ostojaatanasijevic/DS100M08V/documentation/figs/3d_view_top.png

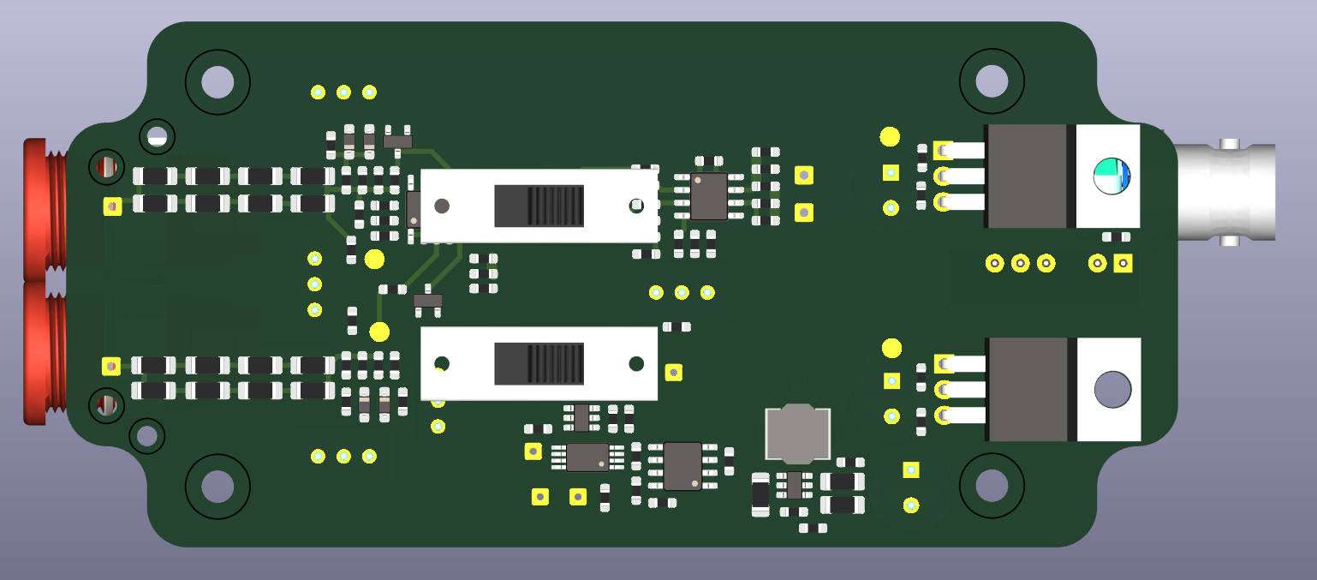
documentation/figs/3d_view_top.png
