ostojaatanasijevic/DS100M08V/documentation/figs/case.png

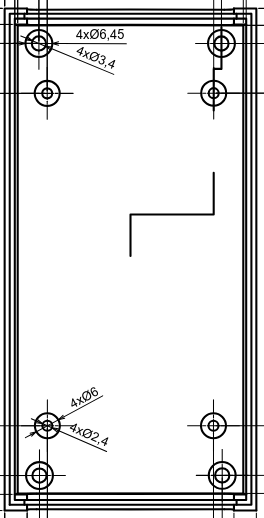
documentation/figs/case.png
