ostojaatanasijevic/DS100M08V/documentation/figs/pomona.webp

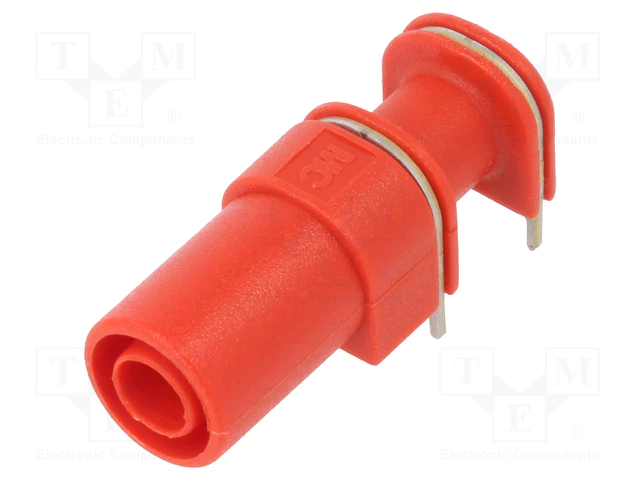
documentation/figs/pomona.webp
