ostojaatanasijevic/DS100M08V/BOM.xls

 |  | Order Qty. | Price (EUR) | Ext.: (EUR)
667-ERJ-PA3J101V | Thick Film Resistors - SMD 0603 100ohm 5% Anti-Surge AEC-Q200 | 2 | 0.035 | 0.07 | 0.7
667-ERA-3AEB103V | Thin Film Resistors - SMD 0603 1/10W 10Kohms 0.1% 25ppm | 10 | 0.087 | 0.87 | 1.74
791-0805N100J501CT | Multilayer Ceramic Capacitors MLCC - SMD/SMT 10pF, +-5%, 500V | 8 | 0.053 | 0.424 | 1.06
768-JR500HV | Trimmer/Variable Capacitors 8.0 - 50PF 350V | 2 | 3.95 | 7.9 | 19.75
80-C0603C105K4PAC | Multilayer Ceramic Capacitors MLCC - SMD/SMT 16V 1uF X5R 0603 10% | 5 | 0.03 | 0.15 | 3
621-BAT54S-F | Schottky Diodes & Rectifiers 30V 350mW | 10 | 0.089 | 0.89 | 0.89
652-CR0603FX-1000ELF | Thick Film Resistors - SMD 100ohm 1% 1/10W | 2 | 0.005 | 0.01 | 0.5
603-RT0603BRD101KL | Thin Film Resistors - SMD 1K ohm 0.1% 25 ppm Thin Film | 10 | 0.069 | 0.69 | 6.9
603-CC603JRNPO8BN471 | Multilayer Ceramic Capacitors MLCC - SMD/SMT 25 V 470pF C0G 0603 5% | 6 | 0.039 | 0.234 | 1.56
https://www.tme.eu/rs/en/details/ad8039arz/smd-operational-amplifiers/analog-devices/ |  | 1 | 3 | 3
https://www.tme.eu/rs/en/details/ad8009arz/smd-operational-amplifiers/analog-devices/ |  | 1 | 2.65 | 2.65
https://www.tme.eu/rs/en/details/am1ds-0509djz/dc-dc-converters/aimtec/ |  | 1 | 2.7 | 2.7
7805 |  | 1 | 0.3 | 0.3
7905 |  | 1 | 0.3 | 0.3
BNC connector |  | 1 | 1.4 | 1.4
4 mm | https://www.aliexpress.com/item/1005005352800055.html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 | 2 | 1.26 | 2.52
kutija | https://www.mgelectronic.rs/kupl-z98 | 1 | 2.5 | 2.5
USB B | https://www.mgelectronic.rs/mini-usb-b-uti%C4%8Dnica-smd-4-pina | 1 | 0.8 | 0.8
USB C | https://eu.mouser.com/ProductDetail/TE-Connectivity/2480843-1?qs=dbcCsuKDzFVHhjcKyfNgvQ%3D%3D | 1 | 1.47 | 1.47
PCB |  | 1 | 1 | 1
4 mm kabl | za sodnu | 2 | 1 | 2
krokodilke |  | 2 | 1.7 | 3.4
603-RT0603BRD0710KL | Thin Film Resistors - SMD 10K ohm 0.1% 1/10W | 2 | 0.063 | 0.126
 |  |  |  | 0
 |  |  |  | 0
 |  |  |  | 35.404
