ostojaatanasijevic/DS100M08V/simulacije/910_offset_calibration.asc

C1: cap; 10p
C2: cap; 10p
C3: cap; 10p
C4: cap; 10p
C9: cap; 120p
C11: cap; 47p
C13: cap; 470p
C16: cap; 360p
C21: cap; {par_cap}
R1: res; {1Meg * (100 +res_tol)/100}
R2: res; 10Meg
R3: res; 10k
R4: res; {100k * x}
R5: res; {100k - x*100k}
R7: res; 25
R11: res; {1Meg * (100 +res_tol)/100}
R12: res; {1Meg * (100 +res_tol)/100}
R13: res; {1Meg * (100 +res_tol)/100}
U2: AD8038
V1: voltage; 2.75
V2: voltage; -2.75
V3: voltage; -3m
V4: voltage; SINE(0 0 10Meg)
V5: voltage; 9
V6: voltage; -9
V7: voltage; {five}
V8: voltage; {five}
Named nets: 0, 2.5V, -2.5V, 5V, -5V, 9V, -9V
.tran 0 1u 0 1n
1 / 400
.param five=5
82.5 dB CMRR at 100 kHz
.param tolerance=-1
.param par_cap=10p
.param res_tol=-0.1
.param gain=100
.step param x 0.1 0.9 0.1
