ostojaatanasijevic/DS100M08V/simulacije/ac_analysis.asc

B1: bv; V=20*(V(diff+) - V(diff-))
C1: cap; {par_cap}
C2: cap; 470p
C3: cap; 10p
C4: cap; 10p
C5: cap; 10p
C6: cap; 10p
C7: cap; 470p
C8: cap; 470p
C9: cap; 10p
C10: cap; 10p
C11: cap; 10p
C12: cap; 10p
C15: cap; 55.5p
C16: cap; 55.5p
C17: cap; {par_cap}
C18: cap; {par_cap}
C19: cap; {par_cap}
C20: cap; {par_cap}
C21: cap; 470p
R1: res; {1Meg * (100 +res_tol)/100}
R2: res; {1Meg * (100 +res_tol)/100}
R3: res; {1Meg * (100 +res_tol)/100}
R4: res; {1Meg * (100 +res_tol)/100}
R5: res; 10k
R10: res; 10k
R11: res; 25
R12: res; 25
R13: res; {Rf / 200 * gain * (100 + tolerance) / 100}
R14: res; {1Meg * (100 +res_tol)/100}
R15: res; {Rf * (100 - tolerance)/100}
R16: res; {Rf * (100 - tolerance)/100}
R17: res; 100k
R18: res; {Rf / 200 * gain * (100 + tolerance) / 100}
R19: res; {1Meg * (100 +res_tol)/100}
R20: res; {1Meg * (100 +res_tol)/100}
R21: res; {1Meg * (100 +res_tol)/100}
U2: AD8039
U3: AD8039
U4: AD8009an
V1: voltage; 2.75
V2: voltage; -2.75
V3: voltage; ""; AC 100
V4: voltage; 9
V5: voltage; 10
V6: voltage; -9
V7: voltage; {five}
V8: voltage; {five}
V9: voltage; ""; AC 100
Named nets: 0, 2.5V, -2.5V, 5V, -5V, 9V, -9V, diff+, diff-
;tran 0 10m 0 1n
1 / 400
.param five=5
82.5 dB CMRR at 100 kHz
.param tolerance=-1
.param par_cap=10p
.param res_tol=-0.1
.param gain=100
.ac dec 100 100 150Meg
.param Rf = 1000
