ostojaatanasijevic/DS100M08V/simulacije/ac_analysis_wider_output.asc

B1: bv; V=20*(V(diff+) - V(diff-))
C1: cap; {par_cap}
C2: cap; 470p
C3: cap; 10p
C4: cap; 10p
C5: cap; 10p
C6: cap; 10p
C7: cap; 470p
C8: cap; 470p
C9: cap; 10p
C10: cap; 10p
C11: cap; 10p
C12: cap; 10p
C13: cap; 100n
C15: cap; 55.5p
C16: cap; 55.5p
C17: cap; {par_cap}
C18: cap; {par_cap}
C19: cap; {par_cap}
C20: cap; {par_cap}
C21: cap; 470p
D1: diode; 1N4148
D2: diode; 1N4148
Q1: npn; 2N3904
Q2: pnp; 2N3906
Q3: npn; 2N3904
R1: res; {1Meg * (100 +res_tol)/100}
R2: res; {1Meg * (100 +res_tol)/100}
R3: res; {1Meg * (100 +res_tol)/100}
R4: res; {1Meg * (100 +res_tol)/100}
R5: res; 10k
R6: res; 50k
R7: res; {100k * (1 - rot)}
R8: res; {100k * (rot)}
R9: res; 2k
R10: res; 10k
R11: res; 25
R12: res; 25
R13: res; {Rf / 200 * gain * (100 + tolerance) / 100}
R14: res; {1Meg * (100 +res_tol)/100}
R15: res; {Rf * (100 - tolerance)/100}
R16: res; {Rf * (100 - tolerance)/100}
R17: res; 100k
R18: res; {Rf / 200 * gain * (100 + tolerance) / 100}
R19: res; {1Meg * (100 +res_tol)/100}
R20: res; {1Meg * (100 +res_tol)/100}
R21: res; {1Meg * (100 +res_tol)/100}
R22: res; 2k
R23: res; 3
R24: res; 3
R25: res; 200
R26: res; 50
R27: res; 2k
U1: AD8009an
U2: AD8039
U3: AD8039
U4: AD8009an
V1: voltage; 2.75
V2: voltage; -2.75
V3: voltage; ""; AC 100
V4: voltage; 9
V5: voltage; 10
V6: voltage; -9
V7: voltage; {five}
V8: voltage; {five}
V9: voltage; ""; AC 100
V10: voltage; 15
V11: voltage; -15
Named nets: 0, 2.5V, -2.5V, 5V, -5V, 9V, -9V, diff+, diff-, 15V, -15V
;tran 0 10m 0 1n
1 / 400
.param five=5
82.5 dB CMRR at 100 kHz
.param tolerance=-1
.param par_cap=10p
.param res_tol=-0.1
.param gain=100
.ac dec 100 0.1 150Meg
.param Rf = 1000
.param rot = 0.6
