ostojaatanasijevic/DS100M08V/simulacije/701_capacitance_multiplier.asc

B1: bv; V=-V(vcc_in)
C1: cap; 47µ
C2: cap; 47µ
C3: cap; 47µ
I1: current; 30m
I2: current; 30m
I3: current; -30m
Q1: npn; 2N3904
Q2: pnp; 2N2905
R1: res; 1k
R2: res; 3.3k
R3: res; 1k
R4: res; 1k
R5: res; 2.2k
R6: res; 1k
R7: res; 2.2k
R322: res; 3.3k
U2: bd679
V1: voltage; PULSE(-1 1 0 10u 10u 1n 20u)
V2: voltage; 9
V3: voltage; PULSE(-1 1 0 {t2} {t2} 1n {2*t2})
V4: voltage; 9
Named nets: 0, vee_in, vcc_in
.tran 1000m
.param t2 = 0.5u
.lib BD679.SP3
