ostojaatanasijevic/DS100M08V/simulacije/000_init.asc

B1: bv; V=20*(V(diff+) - V(diff-))
C1: cap; 5p
C2: cap; 360p
C3: cap; 10p
C4: cap; 10p
C5: cap; 10p
C6: cap; 10p
C7: cap; 470p
C8: cap; 470p
C9: cap; 10p
C10: cap; 10p
C11: cap; 10p
C12: cap; 10p
C13: cap; 120p
C14: cap; 120p
C15: cap; 47p
C16: cap; 47p
C17: cap; 20p
C18: cap; 0.5p
C19: cap; 0.5p
C20: cap; 0.5p
C21: cap; 360p
C22: cap; 20p
R1: res; 1Meg
R2: res; 1Meg
R3: res; 1Meg
R4: res; 1Meg
R5: res; 10k
R6: res; 1Meg
R7: res; 1Meg
R8: res; 1Meg
R9: res; 1Meg
R10: res; 10k
R11: res; 25
R12: res; 25
R13: res; 100
R14: res; 100
R15: res; 2000
R16: res; 2000
R17: res; 100k
U2: AD8038
U3: AD8038
U4: AD8009an
V1: voltage; 2.75
V2: voltage; -2.75
V3: voltage; SINE(0 20 50Meg)
V4: voltage; 9
V5: voltage; SINE(400 100 100k)
V6: voltage; -9
V7: voltage; {five}
V8: voltage; {five}
Named nets: 0, 2.5V, -2.5V, 5V, -5V, 9V, -9V, diff+, diff-
.tran 0 10m
.lib TLV354.LIB
.lib lm7171.lib
1 / 400
at +2.75V, max output is 2.5V, meaning peak input is 1kV.
.param five=5
82.5 dB CMRR at 100 kHz
