ostojaatanasijevic/DS100M08V/simulacije/101_varicap.asc

B1: bv; V=20*(V(diff+) - V(diff-))
C1: cap; {par_cap}
C2: cap; 360p
C3: cap; 10p
C4: cap; 10p
C5: cap; 10p
C6: cap; 10p
C7: cap; 470p
C8: cap; 470p
C9: cap; 10p
C10: cap; 10p
C11: cap; 10p
C12: cap; 10p
C13: cap; 120p
C14: cap; 120p
C15: cap; 47p
C16: cap; 47p
C17: cap; {par_cap}
C18: cap; {par_cap}
C19: cap; {par_cap}
C20: cap; {par_cap}
C21: cap; 360p
R1: res; 1Meg
R2: res; 1Meg
R3: res; 1Meg
R4: res; 1Meg
R5: res; 10k
R6: res; 1Meg
R7: res; 1Meg
R8: res; 1Meg
R9: res; 1k
R10: res; 10k
R11: res; 25
R12: res; 25
R13: res; {10 * gain * (100 + tolerance) / 100}
R14: res; 1Meg
R15: res; {2000 * (100 - tolerance)/100}
R16: res; {2000 * (100 - tolerance)/100}
R17: res; 100k
R18: res; {10 * gain * (100 + tolerance) / 100}
U1: SMV1255
U2: AD8038
U3: AD8038
U4: AD8009an
V1: voltage; 2.75
V2: voltage; -2.75
V3: voltage; SINE(0 200 50Meg)
V4: voltage; 9
V5: voltage; SINE(400 100 10Meg)
V6: voltage; -9
V7: voltage; {five}
V8: voltage; {five}
V9: voltage; 4
Named nets: 0, 2.5V, -2.5V, 5V, -5V, 9V, -9V, diff+, diff-
.tran 0 10m 0 1n
1 / 400
.param five=5
82.5 dB CMRR at 100 kHz
.param tolerance=-1
.param par_cap=10p
.param res_tol=-0.1
.param gain=100
.lib SMV1255-079LF.lib
