ostojaatanasijevic/DS100M08V/simulacije/102_varicap_only.asc

C1: cap; 100n
C2: cap; 100p
R9: res; 100k
U1: SMV1255
V1: voltage; 2.75
V2: voltage; -2.75
V4: voltage; 9
V6: voltage; -9
V7: voltage; {five}
V8: voltage; {five}
V9: voltage; {bias}
V10: voltage; SINE(0 1 1Meg)
Named nets: 0, 2.5V, -2.5V, 9V, -9V, 5V, -5V, mid, input
.tran 0 100.26u 100.24u
.param five=5
.lib SMV1255-079LF.lib
.step param bias list 0 1 2 3 4 5
