ostojaatanasijevic/DS100M08V/simulacije/201_pwm_buffer.asc

C1: cap; 1µ
C3: cap; 1µ
R1: res; 100k
U1: opamp2; TLV9062
U2: opamp2; TLV9062
V1: voltage; 2.75
V2: voltage; -2.75
V3: voltage; PULSE(0 5 0 0 0 {d * 10u} 10u)
V4: voltage; 9
V6: voltage; -9
V7: voltage; {five}
V8: voltage; {five}
Named nets: 0, 2.5V, -2.5V, 9V, -9V, 5V, -5V, leak
.tran 0 100m 0 uic
.param five=5
.step param d list 0.1 0.2 0.3 0.4
.lib tlv9062.lib
.ic V(leak) = 1
