ostojaatanasijevic/DS100M08V/simulacije/400_output_offset.asc

B1: bv; V=20*(V(diff+) - V(diff-))
C1: cap; {par_cap}
C17: cap; {par_cap}
R1: res; {Rf*100}
R2: res; {(1- ratio) * 100k}
R3: res; {(ratio) * 100k}
R4: res; {Rf/20}
R5: res; {Rf}
R6: res; {Rf}
R7: res; {Rf/20}
R9: res; {(1- ratio) * 100k}
R10: res; {(ratio) * 100k}
R11: res; {Rf*50}
R13: res; {Rf/2}
R15: res; {Rf}
R16: res; {Rf}
R17: res; 100k
R18: res; {Rf/2}
U1: AD8009an
U4: AD8009an
V1: voltage; 2.75
V2: voltage; -2.75
V3: voltage; PULSE(0.2 -0.2 0 500p 500p 10n 20n)
V4: voltage; 9
V5: voltage; PULSE(-0.2 0.2 0 500p 500p 10n 20n)
V6: voltage; -9
V7: voltage; {five}
V8: voltage; {five}
Named nets: 0, 2.5V, -2.5V, 9V, -9V, 5V, -5V, diff+, diff-, output_2, output
.tran 0 100n 0 1n
.param five=5
82.5 dB CMRR at 100 kHz
.step param Rf list 200 1k 2k
.param tolerance=-1
.param par_cap=10p
.param res_tol=-0.1
.param gain=100
.param ratio = 0.01
