ostojaatanasijevic/DS100M08V/simulacije/700_psu.asc

C1: cap; 10µ
C2: cap; 10µ
C3: cap; 3.43p
C4: cap; 3.43p
D1: diode; 1N4148
L1: ind; 4.7µ
L2: ind; 4.7µ
M1: nmos; BSC060N10NS3
R1: res; 50
R2: res; 8570
R3: res; 35m
R4: res; 8570
R5: res; 35m
V1: voltage; PULSE(0 10 0 0 0 {d / f} {1/f})
V2: voltage; 3.6V
Named nets: 0
.param f = 1Meg
.param d = 0.32
.tran 1000m
