ostojaatanasijevic/DS100M08V/simulacije/Draft1.asc

L1: ind; 61.4µ
R1: res; 149.6
V1: voltage; SINE(0 0.456 100k)
Named nets: 0
.tran 1m
