ostojaatanasijevic/DS100M08V/DS100M08KV.kicad_pcb

## KiCad design DS100M08KV.kicad_pcb (2025-10-20)

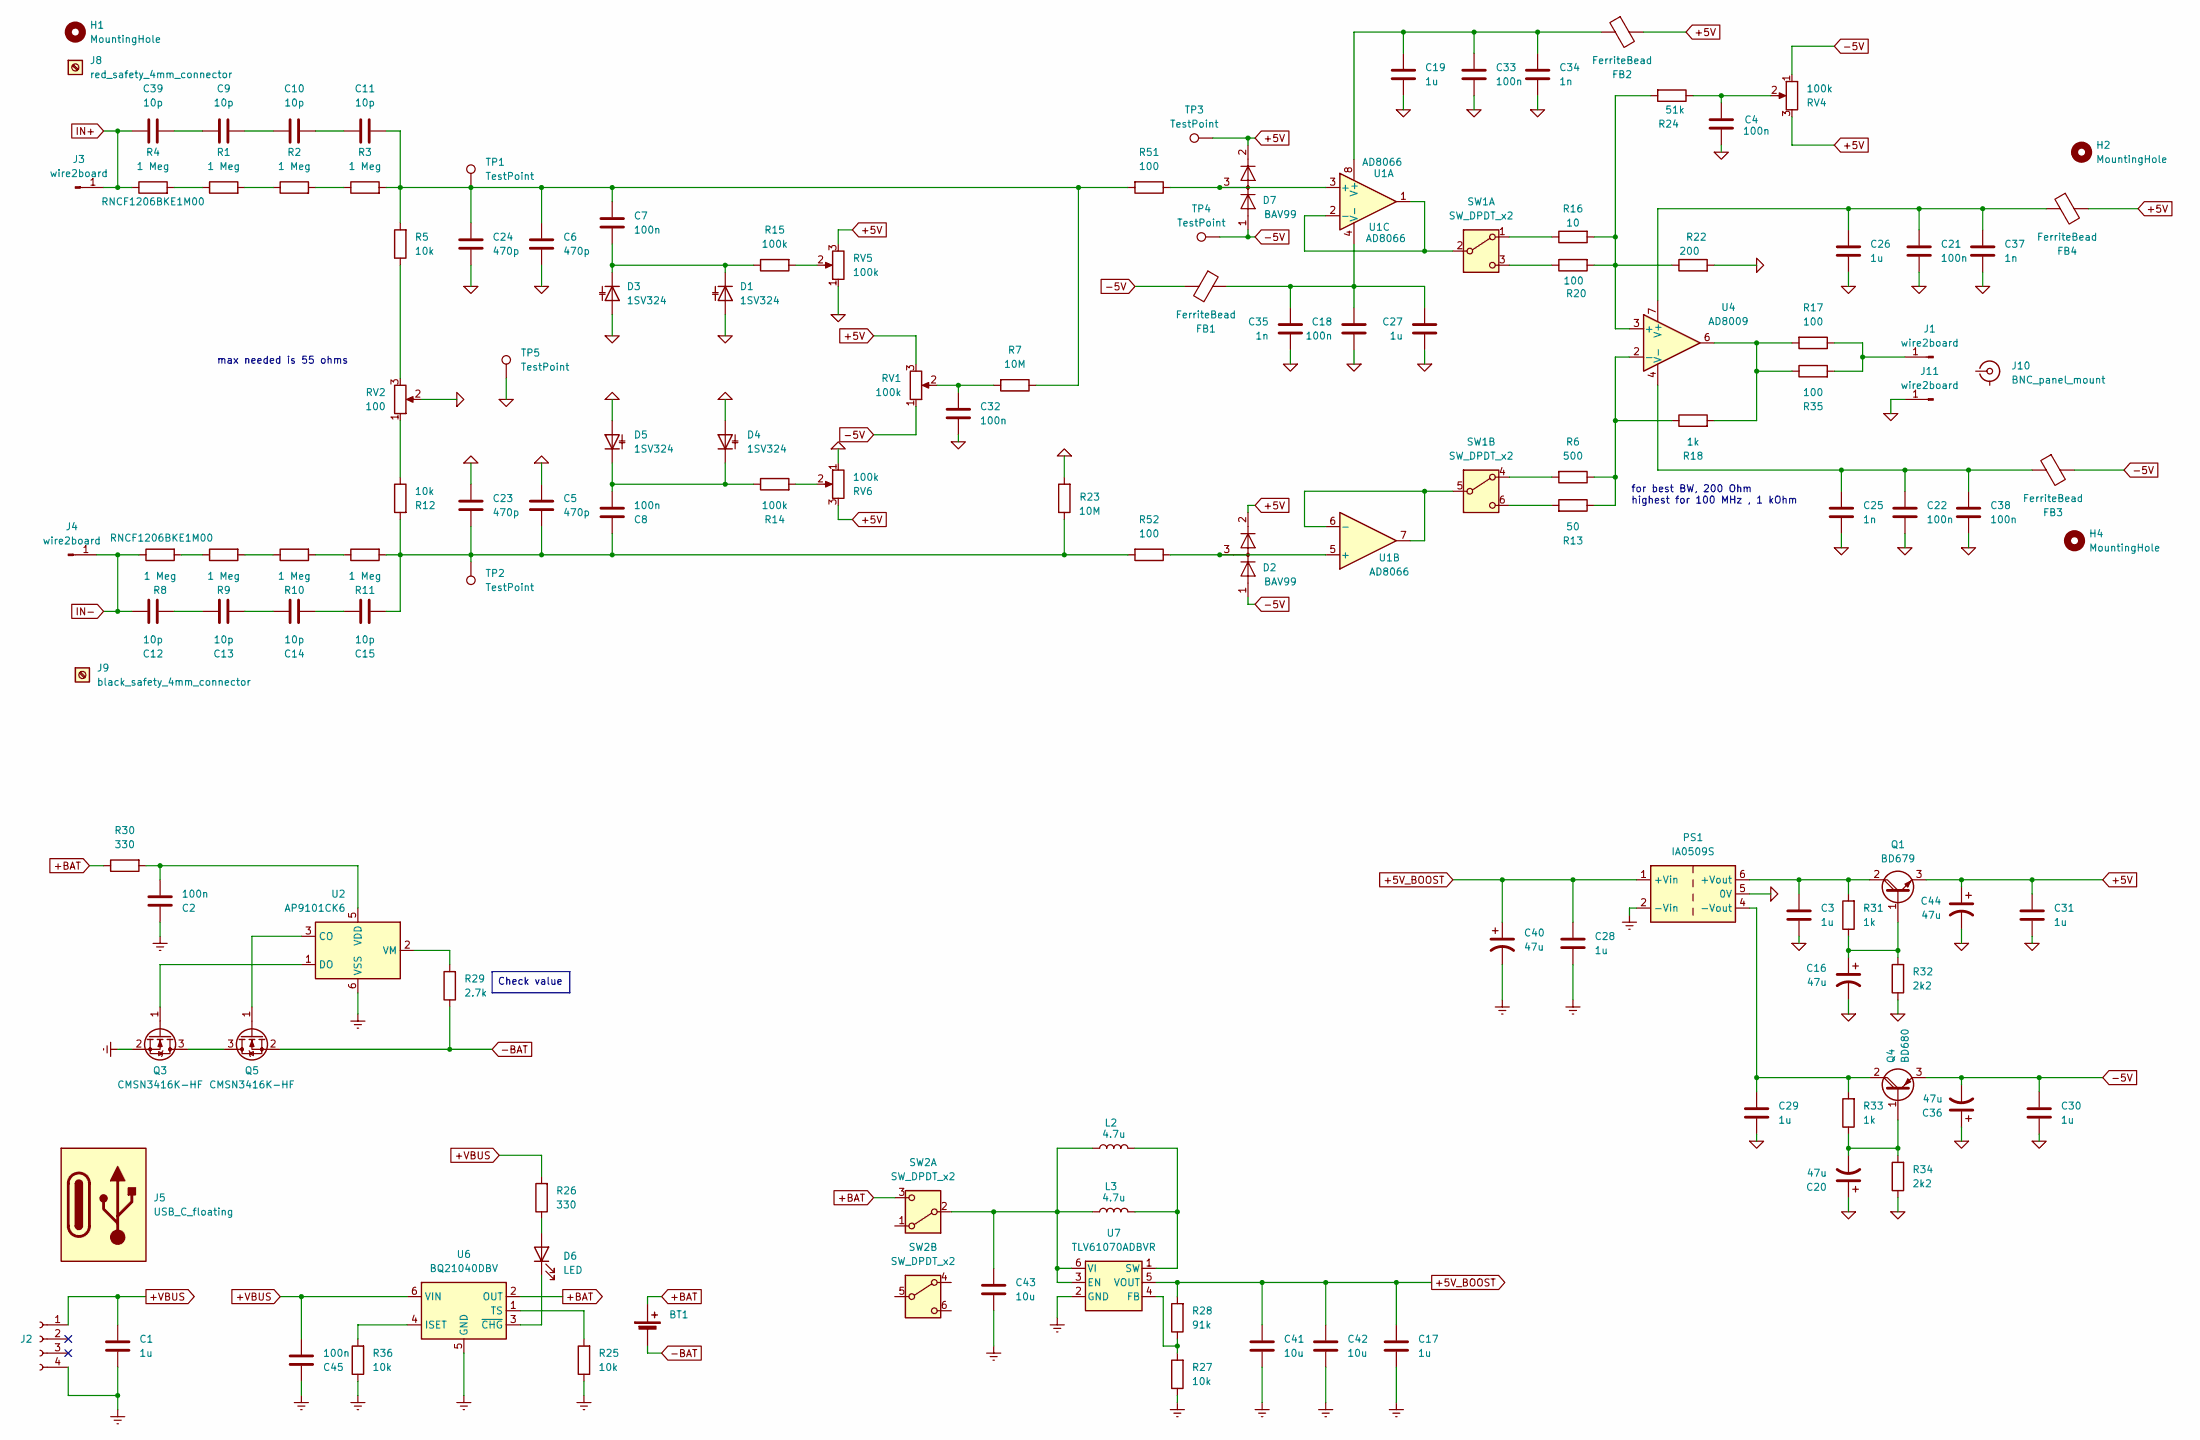
[picture p8: schematic DS100M08KV.kicad_sch, 1:200 800V 100 MHz differential probe]

Parts:
BT1: Battery_Cell; battery_holder
C1, C3, C17, C19, C26, C27, C28, C29, C30, C31: 1u; R_0603_1608Metric_Pad0.98x0.95mm_HandSolder
C2, C4, C7, C8, C18, C21, C22, C32, C33, C38, C45: 100n; R_0603_1608Metric_Pad0.98x0.95mm_HandSolder
C5, C6, C23, C24: 470p; R_0603_1608Metric_Pad0.98x0.95mm_HandSolder
C9, C10, C11, C12, C13, C14, C15, C39: 10p; R_1206_3216Metric_Pad1.30x1.75mm_HandSolder
C16, C20, C36, C40, C44: 47u; CP_Radial_D5.0mm_P2.00mm
C25, C34, C35, C37: 1n; R_0603_1608Metric_Pad0.98x0.95mm_HandSolder
C41, C42, C43: 10u; R_1206_3216Metric_Pad1.30x1.75mm_HandSolder
D1, D3, D4, D5: 1SV324; D_SOD-323_HandSoldering
D2, D7: BAV99; SOT-23
D6: LED; LED_D3.0mm_FlatTop
FB1, FB2, FB3, FB4: FerriteBead; L_0603_1608Metric_Pad1.05x0.95mm_HandSolder
H1, H2, H4: MountingHole; M3_with_screw
J1, J3, J4, J11: wire2board; SolderWire-0.25sqmm_1x01_D0.65mm_OD1.7mm
J2: Conn_01x04_Socket; JST_PH_B4B-PH-K_1x04_P2.00mm_Vertical
J5: USB_C_floating
J8: red_safety_4mm_connector; black_safety_4mm_connector
J9: black_safety_4mm_connector
J10: BNC_panel_mount
L2: 4.7u; L_Radial_D7.5mm_P3.50mm_Fastron_07P
L3: 4.7u; L_Bourns_SRN6045TA
PS1: IA0509S; Converter_DCDC_XP_POWER-IAxxxxS_THT
Q1: BD679; TO-126-3_Vertical
Q3, Q5: CMSN3416K-HF; SOT-23
Q4: BD680; TO-126-3_Vertical
R1, R2, R3, R9, R10, R11: 1 Meg; R_1206_3216Metric_Pad1.30x1.75mm_HandSolder
R4, R8: 1 Meg; R_1206_3216Metric_Pad1.30x1.75mm_HandSolder; Partnumber RNCF1206BKE1M00
R5, R12, R25, R27, R36: 10k; R_0603_1608Metric_Pad0.98x0.95mm_HandSolder
R6: 500; R_0603_1608Metric_Pad0.98x0.95mm_HandSolder
R7, R23: 10M; R_0603_1608Metric_Pad0.98x0.95mm_HandSolder
R13: 50; R_0603_1608Metric_Pad0.98x0.95mm_HandSolder
R14, R15: 100k; R_0603_1608Metric_Pad0.98x0.95mm_HandSolder
R16: 10; R_0603_1608Metric_Pad0.98x0.95mm_HandSolder
R17, R20, R35, R51, R52: 100; R_0603_1608Metric_Pad0.98x0.95mm_HandSolder
R18, R31, R33: 1k; R_0603_1608Metric_Pad0.98x0.95mm_HandSolder
R22: 200; R_0603_1608Metric_Pad0.98x0.95mm_HandSolder
R24: 51k; R_0603_1608Metric_Pad0.98x0.95mm_HandSolder
R26, R30: 330; R_0603_1608Metric_Pad0.98x0.95mm_HandSolder
R28: 91k; R_0603_1608Metric_Pad0.98x0.95mm_HandSolder
R29: 2.7k; R_0603_1608Metric_Pad0.98x0.95mm_HandSolder
R32, R34: 2k2; R_0603_1608Metric_Pad0.98x0.95mm_HandSolder
RV1, RV4, RV5, RV6: 100k; Potentiometer_Bourns_3296W_Vertical
RV2: 100; Potentiometer_Bourns_3296W_Vertical
SW1, SW2: SW_DPDT_x2; DPDT_bigger
TP1, TP2, TP3, TP4, TP5: TestPoint; TestPoint_Pad_D2.0mm
U1: AD8066; SOIC-8_3.9x4.9mm_P1.27mm
U2: AP9101CK6; SOT-23-6
U4: AD8009; SOIC-8_3.9x4.9mm_P1.27mm
U6: BQ21040DBV; SOT-23-6
U7: TLV61070ADBVR; SOT-23-6

Connections:
0: C3.2, C4.1, C5.1, C6.1, C16.2, C18.1, C19.1, C20.1, C21.1, C22.1, C23.1, C24.1, C25.1, C26.1, C27.1, C29.2, C30.2, C31.2, C32.1, C33.1, C34.1, C35.1, C36.1, C37.1, C38.1, C44.2, D1.2 (A), D3.2 (A), D4.2 (A), D5.2 (A), J11.1, PS1.5 (0V), R22.2, R23.2, R32.1, R34.1, RV2.2, RV5.1, RV6.1, TP5.1
+5V: C31.1, C44.1, D2.2 (A), D7.2 (A), FB2.2, FB4.2, Q1.3 (E), RV1.3, RV4.3, RV5.3, RV6.3, TP3.1
+5V_BOOST: C17.2, C28.1, C40.1, C41.2, C42.2, PS1.1 (+Vin), R28.2, U7.5 (VOUT)
+BAT: BT1.1 (+), R30.1, SW2.3 (C), U6.2 (OUT)
+VBUS: C1.1, C45.1, J2.1, R26.2, U6.6 (VIN)
-5V: C30.1, C36.2, D2.1 (K), D7.1 (K), FB1.2, FB3.2, Q4.3 (E), RV1.1, RV4.1, TP4.1
-BAT: BT1.2 (-), Q5.2 (S), R29.1
Earth: C1.2, C2.2, C17.1, C28.2, C40.2, C41.1, C42.1, C43.1, C45.2, J2.4, PS1.2 (-Vin), Q3.2 (S), R25.1, R27.1, R36.1, U2.6 (VSS), U6.5 (GND), U7.2 (GND)
IN+: C39.2, J3.1, R4.1
IN-: C12.2, J4.1, R8.1
unnamed: C4.2, R24.1, RV4.2
unnamed: C10.1, C11.2
unnamed: C9.1, C10.2
unnamed: C6.2, C7.2, C11.1, C24.2, R3.2, R5.2, R7.1, R51.2, TP1.1
unnamed: C12.1, C13.2
unnamed: C13.1, C14.2
unnamed: C14.1, C15.2
unnamed: C5.2, C8.2, C15.1, C23.2, R11.2, R12.2, R23.1, R52.2, TP2.1
unnamed: C32.2, R7.2, RV1.2
unnamed: C9.2, C39.1
unnamed: C7.1, D1.1 (K), D3.1 (K), R15.1
unnamed: C8.1, D4.1 (K), D5.1 (K), R14.1
unnamed: D6.2 (A), R26.1
unnamed: D6.1 (K), U6.3 (~CHG)
unnamed: J1.1, R17.1, R35.2
unnamed: C3.1, PS1.6 (+Vout), Q1.2 (C), R31.2
unnamed: C29.1, PS1.4 (-Vout), Q4.2 (C), R33.2
unnamed: C16.1, Q1.1 (B), R31.1, R32.2
unnamed: Q3.3 (D), Q5.3 (D)
unnamed: Q3.1 (G), U2.1 (DO)
unnamed: C20.2, Q4.1 (B), R33.1, R34.2
unnamed: Q5.1 (G), U2.3 (CO)
unnamed: R1.1, R4.2
unnamed: R1.2, R2.1
unnamed: R2.2, R3.1
unnamed: R5.1, RV2.3
unnamed: R8.2, R9.1
unnamed: R9.2, R10.1
unnamed: R10.2, R11.1
unnamed: R12.1, RV2.1
unnamed: R14.2, RV6.2
unnamed: R15.2, RV5.2
unnamed: R17.2, R18.2, R35.1, U4.6
unnamed: R16.1, SW1.1 (A)
unnamed: SW1.2 (B), U1.1, U1.2 (-)
unnamed: R20.1, SW1.3 (C)
unnamed: R6.2, SW1.4 (A)
unnamed: SW1.5 (B), U1.6 (-), U1.7
unnamed: R13.2, SW1.6 (C)
unnamed: C43.2, L2.1, L3.1, SW2.2 (B), U7.3 (EN), U7.6 (VI)
unnamed: D7.3 (K), R51.1, U1.3 (+)
unnamed: D2.3 (K), R52.1, U1.5 (+)
unnamed: C19.2, C33.2, C34.2, FB2.1, U1.8 (V+)
unnamed: C18.2, C27.2, C35.2, FB1.1, U1.4 (V-)
unnamed: C2.1, R30.2, U2.5 (VDD)
unnamed: R29.2, U2.2 (VM)
unnamed: R16.2, R20.2, R22.1, R24.2, U4.3 (+)
unnamed: R6.1, R13.1, R18.1, U4.2 (-)
unnamed: C21.2, C26.2, C37.2, FB4.1, U4.7 (V+)
unnamed: C22.2, C25.2, C38.2, FB3.1, U4.4 (V-)
unnamed: R36.2, U6.4 (ISET)
unnamed: R25.2, U6.1 (TS)
unnamed: R27.2, R28.1, U7.4 (FB)
unnamed: L2.2, L3.2, U7.1 (SW)

Notes on the sheet:
for best BW, 200 Ohm highest for 100 MHz , 1 kOhm
max needed is 55 ohms
Check value

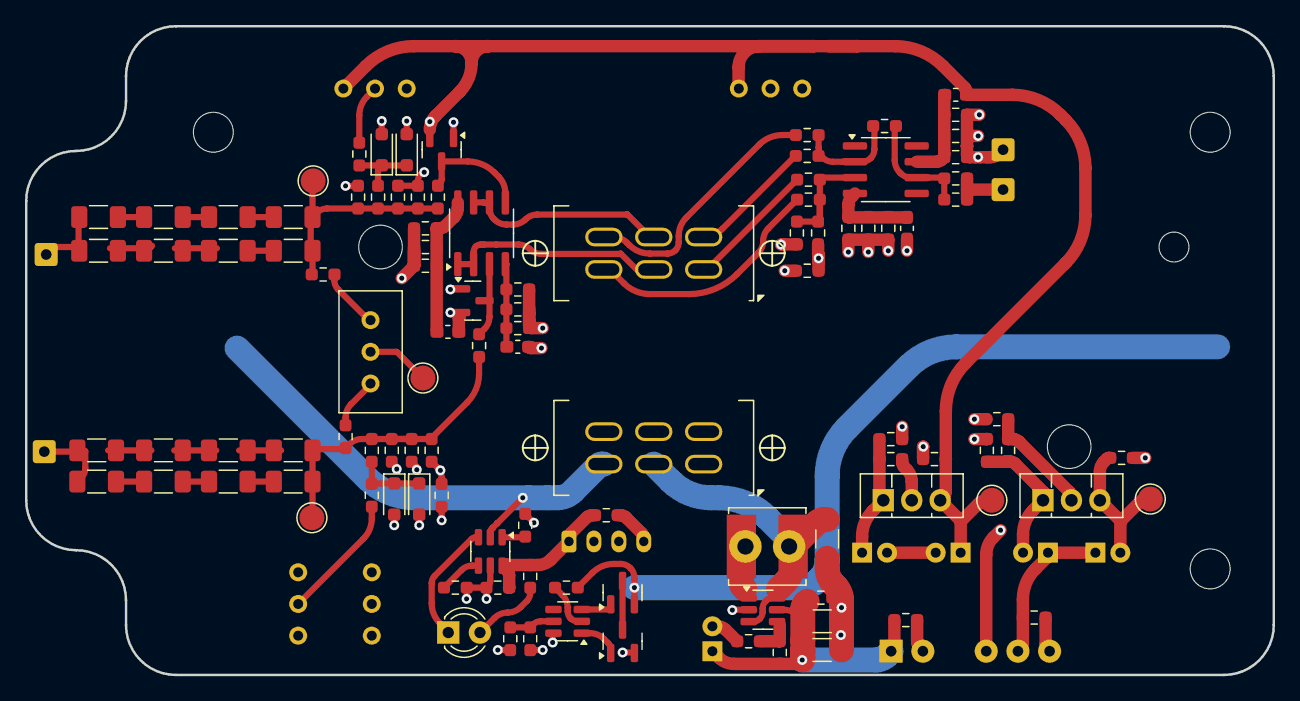
[picture p9: board DS100M08KV.kicad_pcb from above]

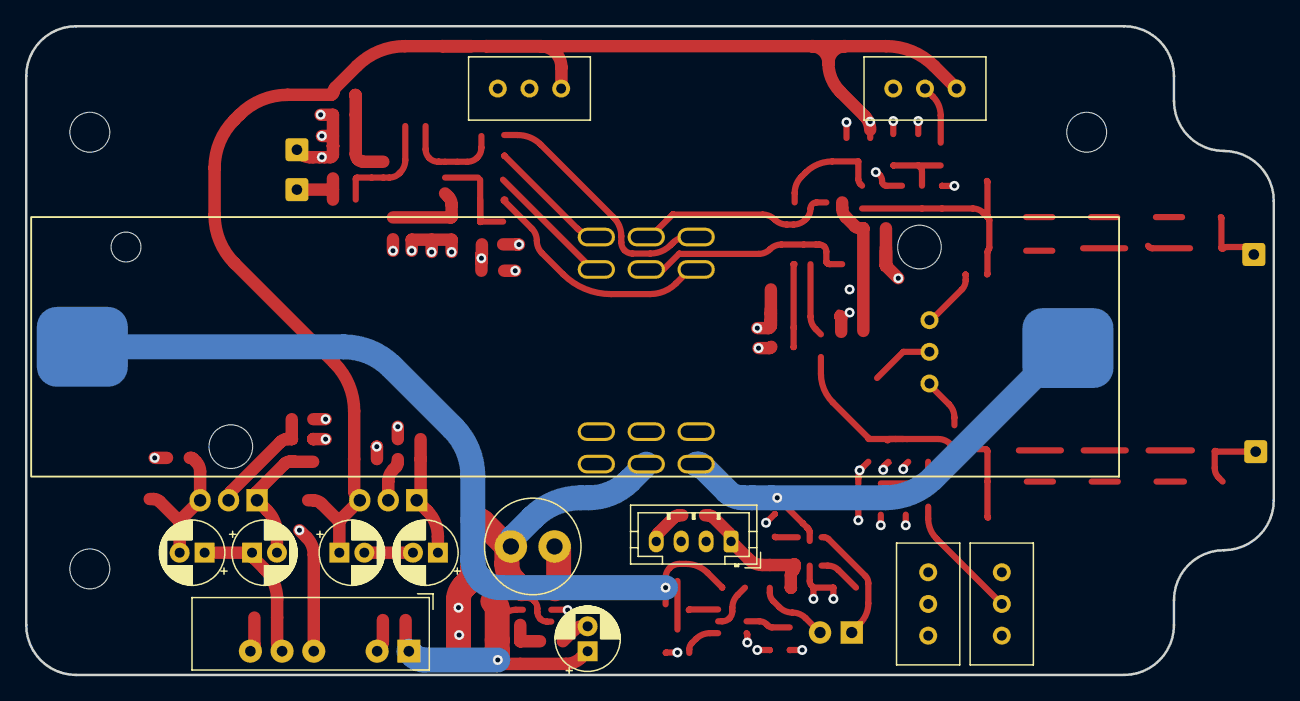
[picture p10: board DS100M08KV.kicad_pcb from below]

Board: 4 copper layers, 100.0 x 52.0 mm, 129 parts (20 on the bottom side), 64 nets.
