ostojaatanasijevic/DS100M08V/(commit log)

2024-10-18 Uskoro sklanjamo buck-ove.
    [BNC-BJ.step, BOM.xls, Banana Plug 4mm Black CT2238 v1.f3d, Banana Plug 4mm Red CT2238 v1.f3d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]
2024-10-18 Back to linear.
    [DS100M06V_linear.kicad_pcb, DS100M06V_linear.kicad_sch]
2024-10-19 Ill flip ya for it.
    [DS100M06V_linear.kicad_pcb, DS100M06V_linear.kicad_sch]
2024-10-20 Veći prekidač.
    [DPDT Slide Switch.step, DS100M06V_linear.kicad_pcb, DS100M06V_linear.kicad_sch, SLIDE_SWITCH_MINIATURE_DPCO.stp]
2024-10-20 Img tst
    [DS100M06V_linear.kicad_pcb, DS100M06V_linear.kicad_sch]
2024-10-20 Layout skoro gotov.
    [DS100M06V_linear.kicad_pcb, DS100M06V_linear.kicad_sch]
2024-10-20 Added PCB spacers.
    [DS100M06V_linear.kicad_pcb, DS100M06V_linear.kicad_sch]
2024-10-29 cap mult sim.
    [DS100M06V_linear.kicad_sch]
2024-10-29 Added capacitance multiplier.
    [18650_LI-ON_Battery_Holder_1042P.STEP, DS100M06V_linear.kicad_pcb, DS100M06V_linear.kicad_sch]
2024-11-02 Fixed electrolytics.
    [DS100M06V_linear.kicad_pcb, DS100M06V_linear.kicad_sch]
2025-04-09 Project rename
    [DS100M08KV-B_Cu.gbr, DS100M08KV-B_Mask.gbr, DS100M08KV-B_Paste.gbr, DS100M08KV-B_Silkscreen.gbr, DS100M08KV-Edge_Cuts.gbr, DS100M08KV-F_Cu.gbr, DS100M08KV-F_Mask.gbr, DS100M08KV-F_Paste.gbr]
2025-04-09 Cleaning up.
    [DS100M08KV-NPTH.drl, DS100M08KV-PTH.drl]
2025-04-09 Cleaning up libraries.
    [DS100M08KV.kicad_pcb, DS100M08KV.kicad_sch]
2025-04-10 small updates.
    [DS100M08KV.kicad_pcb, DS100M08KV.kicad_sch]
2025-04-11 Novi raspored.
    [DS100M08KV.kicad_pcb, DS100M08KV.kicad_sch]
2025-04-13 Rutiranje gotovo.
    [DS100M08KV.kicad_pcb, DS100M08KV.kicad_sch]
2025-04-13 Minor update
    [DS100M08KV.kicad_pcb, DS100M08KV.kicad_sch]
2025-05-18 3d model.
    [DS100M08KV.kicad_pcb]
2025-05-22 Rounded traces..
    [DS100M08KV.kicad_pcb]
2025-10-20 Minor changes to schematic and PCB.
    [DS100M08KV-B_Cu.gbr, DS100M08KV-B_Mask.gbr, DS100M08KV-B_Paste.gbr, DS100M08KV-B_Silkscreen.gbr, DS100M08KV-Edge_Cuts.gbr, DS100M08KV-F_Cu.gbr, DS100M08KV-F_Mask.gbr, DS100M08KV-F_Paste.gbr]
